tn0503/biped_book_files/my_robot_kicad/readme.txt

基板発注について

・基板を1枚で作成する場合

基本的な流れは本文 P115 - P119 に記載の内容に準じます。

1 「my_robot_kicad」フォルダ内の「my_robot.pro」をKicadで開く
2 「my_robot.kicad_pcb」を開く
3 「my_robot_kicad」フォルダ内に「my_robot」という名前でフォルダを作る
4 「my_robot.kicad_pcb」で「プロット」ボタンをクリック
5  出力ディレクトリ―に今作ったフォルダを指定
6 「製造ファイル出力」ボタンをクリック
7 「ゾーンの塗り潰しは古いままです。再度塗り潰しますか？」には「再塗り潰しせずに続行」をクリック
8 「ドリルファイルを生成」ボタンをクリック
9 「ドリルファイルを生成」ボタンをクリック
10 「閉じる」をクリック
11 「閉じる」をクリック
12 「my_robot」フォルダ内のファイル名をすべて「my_robot」に変更
13 「my_robot.drl」を「my_robot.txt」に変更
14 「my_robot」フォルダをzipで圧縮

15 ELECROW社のサイトでアカウント作成
16 ELECROW社のサイトでzipファイルをアップロード、カートに入れる
