tn0503/biped_book_files/my_robot_kicad_alt/readme.txt

基板発注について

・基板を4枚に分けて作成する場合

基本的な流れは本文 P115 - P119 に記載の内容に準じます。

1 「pcb1」フォルダ内の「my_robot.pro」をKicadで開く
2 「my_robot.kicad_pcb」を開く
3 「pcb1」フォルダ内に「pcb_1」という名前でフォルダを作る
4 「my_robot.kicad_pcb」で「プロット」ボタンをクリック
5  出力ディレクトリ―に今作ったフォルダを指定
6 「製造ファイル出力」ボタンをクリック
7 「ゾーンの塗り潰しは古いままです。再度塗り潰しますか？」には「再塗り潰しせずに続行」をクリック
8 「ドリルファイルを生成」ボタンをクリック
9 「ドリルファイルを生成」ボタンをクリック
10 「閉じる」をクリック
11 「閉じる」をクリック
12 「pcb_1」フォルダ内のファイル名をすべて「pcb_1」に変更
13 「pcb_1.drl」を「pcb1.txt」に変更
14 「pcb_1」フォルダをzipで圧縮

15 「pcb2」から「pcb4」についても同様の作業を行う

16 ELECROW社のサイトでアカウント作成
17 ELECROW社のサイトでzipファイルを順番にアップロード、カートに入れる
18 送料が余計にかかるので別々に発注しないように注意
