tn0503/biped_book_files/(list of files, cad)

Other CAD files:
my_robot_fusion/my_robot v16.f3d
