tn0503/biped_book_files/my_robot_kicad_alt/pcb1/my_robot.kicad_pcb

## KiCad design my_robot_kicad_alt/pcb1/my_robot.kicad_pcb (2020-09-24)

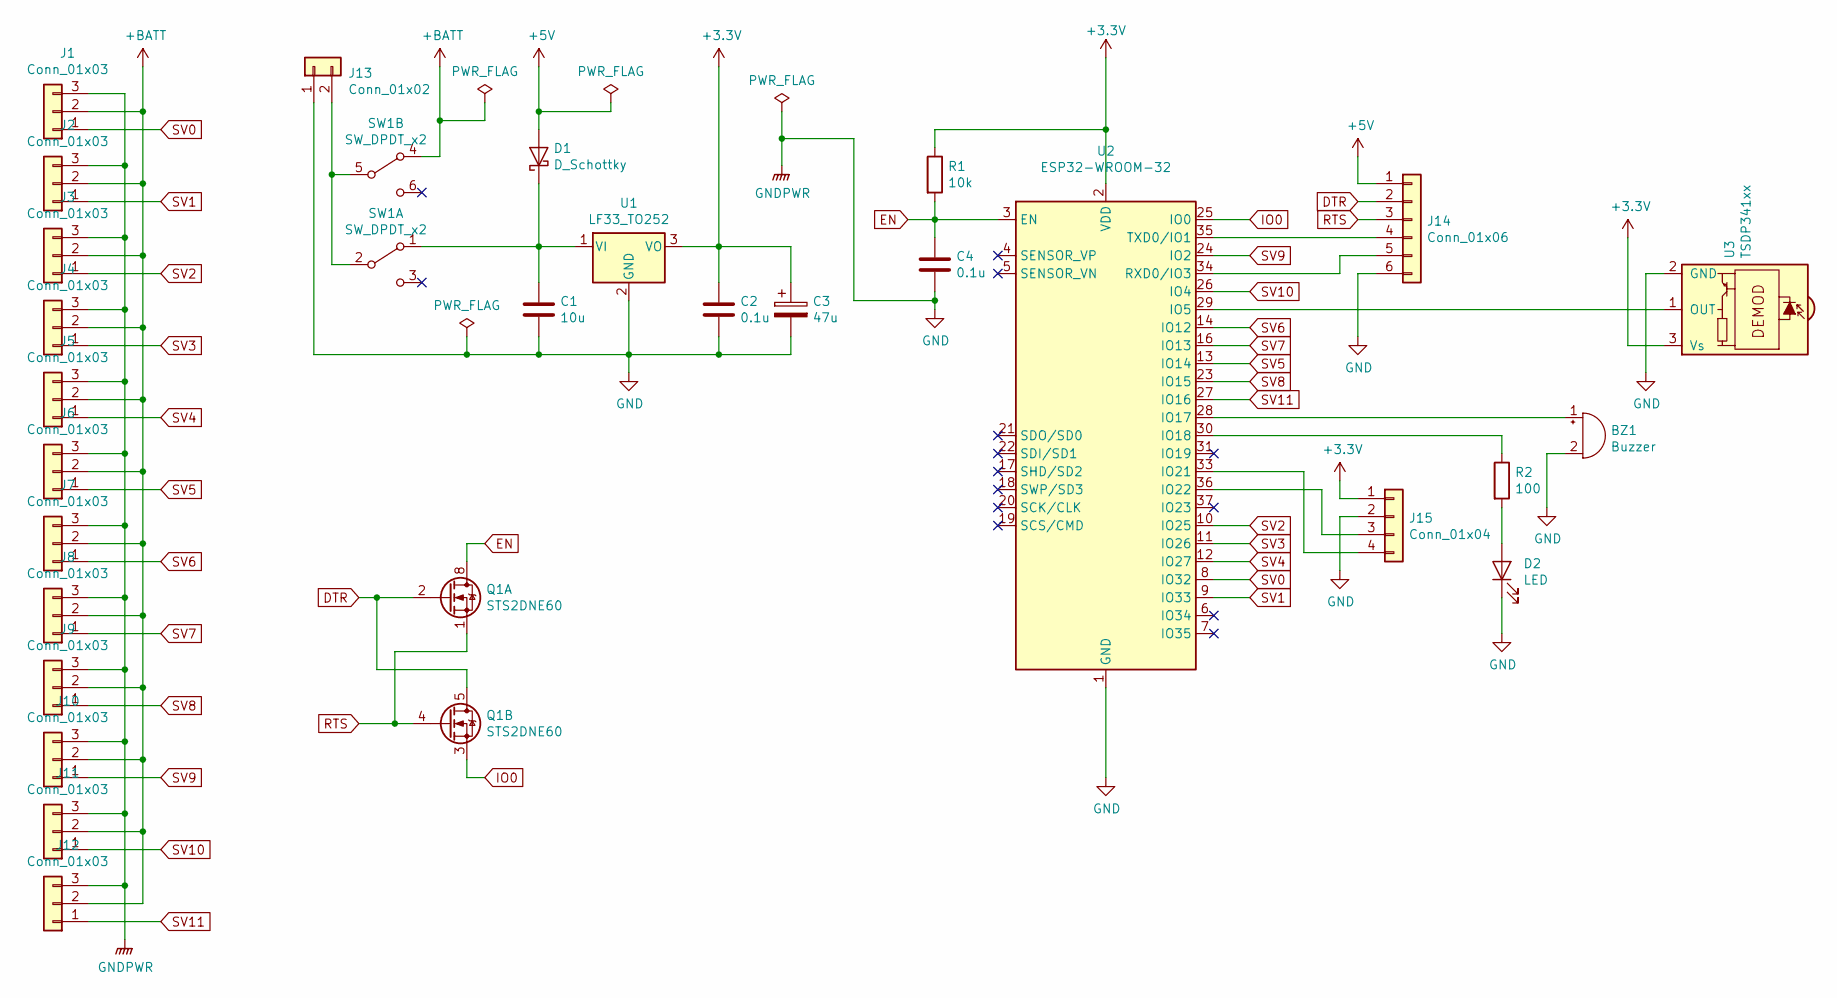
[picture p1: schematic my_robot.sch]

Parts:
BZ1: Buzzer; C_Radial_D10.0mm_H12.5mm_P5.00mm
C1: 10u; C_Rect_L7.0mm_W2.0mm_P5.00mm
C2, C4: 0.1u; C_Rect_L7.0mm_W2.0mm_P5.00mm
C3: 47u; CP_Radial_D6.3mm_P2.50mm
D1: D_Schottky; D_2010_5025Metric
D2: LED; LED_D3.0mm
J1, J2, J3, J4, J5, J6, J7, J8, J9, J10, J11, J12: Conn_01x03; PinHeader_1x03_P2.54mm_Vertical
J13: Conn_01x02; TerminalBlock_bornier-2_P5.08mm
J14: Conn_01x06; PinHeader_1x06_P2.54mm_Vertical
J15: Conn_01x04; PinHeader_1x04_P2.54mm_Vertical
Q1: STS2DNE60; SOIC-8_3.9x4.9mm_P1.27mm
R1: 10k; R_Axial_DIN0204_L3.6mm_D1.6mm_P5.08mm_Horizontal
R2: 100; R_Axial_DIN0204_L3.6mm_D1.6mm_P5.08mm_Horizontal
SW1: SW_DPDT_x2; SW_CuK_JS202011CQN_DPDT_Straight
U1: LF33_TO252; TO-252-2
U2: ESP32-WROOM-32
U3: TSDP341xx; PinHeader_1x03_P2.54mm_Vertical

Connections:
+3V3: C2.1, C3.1, J15.1, R1.1, U1.3 (VO), U2.2 (VDD), U3.3 (Vs)
+5V: D1.2 (A), J14.1
+BATT: J1.2, J2.2, J3.2, J4.2, J5.2, J6.2, J7.2, J8.2, J9.2, J10.2, J11.2, J12.2, SW1.4 (A)
DTR: J14.2, Q1.2 (G1), Q1.5 (D2), Q1.6 (D2)
EN: C4.1, Q1.7 (D1), Q1.8 (D1), R1.2, U2.3 (EN)
GND: BZ1.2 (+), C1.2, C2.2, C3.2, C4.2, D2.1 (K), J1.3, J2.3, J3.3, J4.3, J5.3, J6.3, J7.3, J8.3, J9.3, J10.3, J11.3, J12.3, J13.1, J14.6, J15.2, U1.2 (GND), U2.1 (GND), U2.15 (GND), U2.38 (GND), U2.39 (GND), U3.2 (GND)
IO0: Q1.3 (S2), U2.25 (IO0)
unnamed: BZ1.1 (-), U2.28 (IO17)
unnamed: C1.1, D1.1 (K), SW1.1 (A), U1.1 (VI)
unnamed: D2.2 (A), R2.2
unnamed: J13.2, SW1.2 (B), SW1.5 (B)
unnamed: J14.4, U2.35 (TXD0/IO1)
unnamed: J14.5, U2.34 (RXD0/IO3)
unnamed: J15.3, U2.36 (IO22)
unnamed: J15.4, U2.33 (IO21)
unnamed: R2.1, U2.30 (IO18)
unnamed: U2.29 (IO5), U3.1 (OUT)
RTS: J14.3, Q1.1 (S1), Q1.4 (G2)
SV0: J1.1, U2.8 (IO32)
SV1: J2.1, U2.9 (IO33)
SV2: J3.1, U2.10 (IO25)
SV3: J4.1, U2.11 (IO26)
SV4: J5.1, U2.12 (IO27)
SV5: J6.1, U2.13 (IO14)
SV6: J7.1, U2.14 (IO12)
SV7: J8.1, U2.16 (IO13)
SV8: J9.1, U2.23 (IO15)
SV9: J10.1, U2.24 (IO2)
SV10: J11.1, U2.26 (IO4)
SV11: J12.1, U2.27 (IO16)

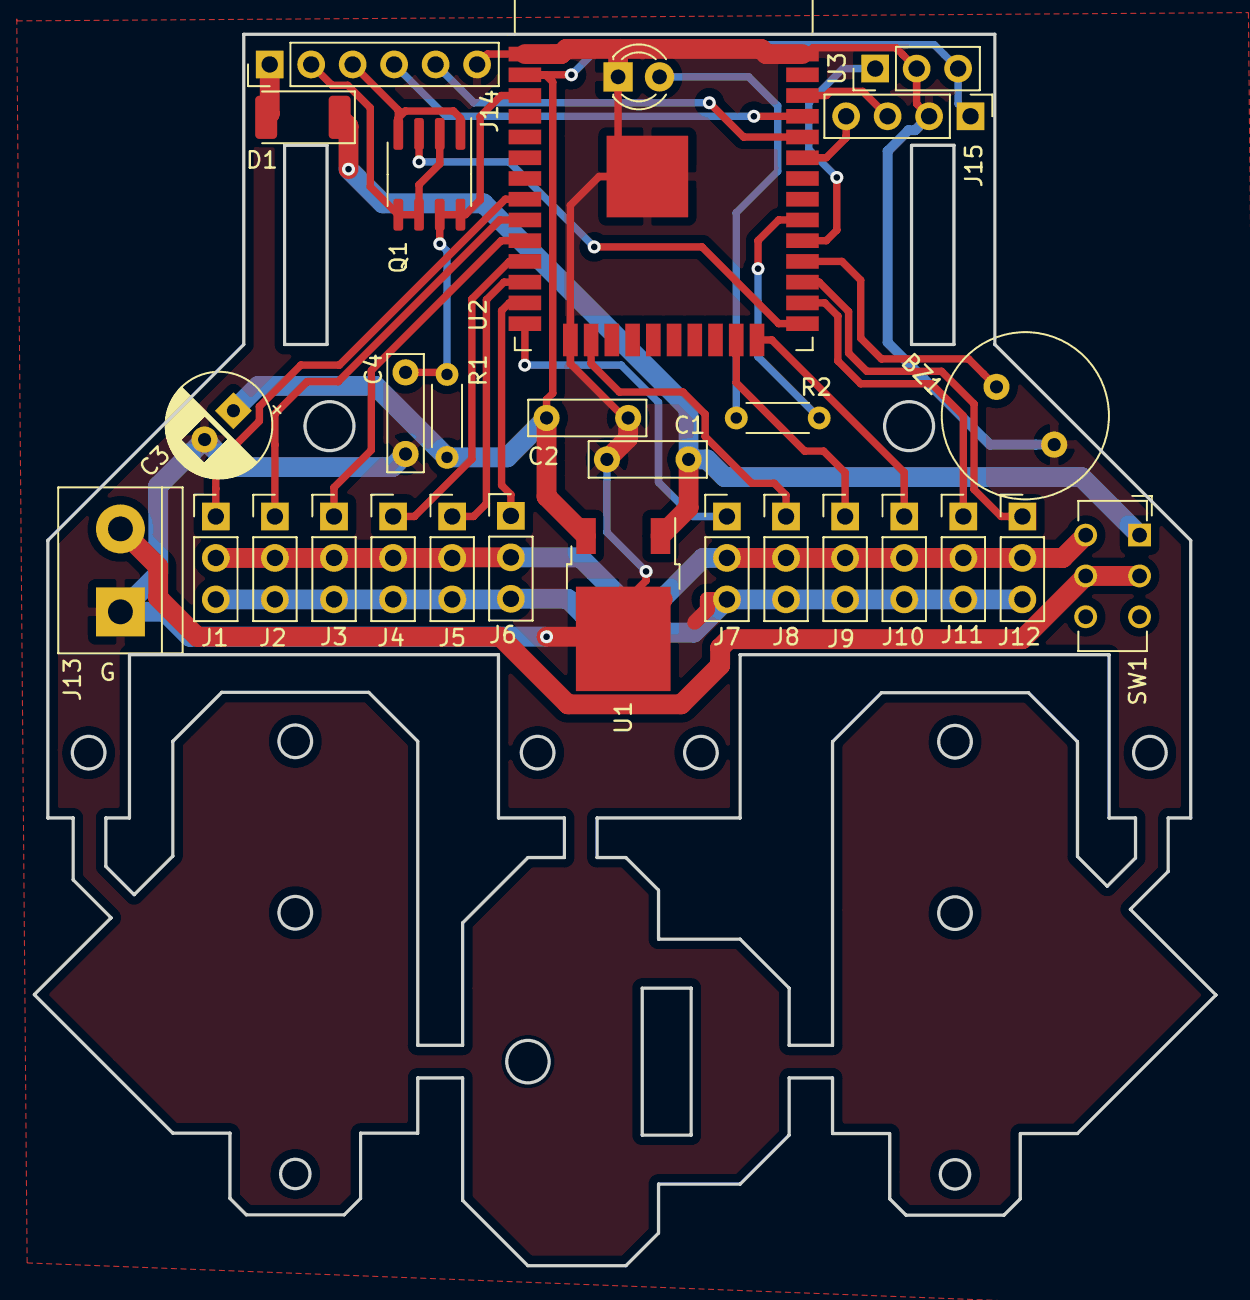
[picture p2: board my_robot.kicad_pcb from above]

Board: 2 copper layers, 72.4 x 75.4 mm, 29 parts (0 on the bottom side), 30 nets.
